jerinabr/XIAO-ESP32C6-Lighting-Control-Board/XIAO_ESP32C6_Control_Board.kicad_pcb

## KiCad design XIAO_ESP32C6_Control_Board.kicad_pcb (2026-08-29)

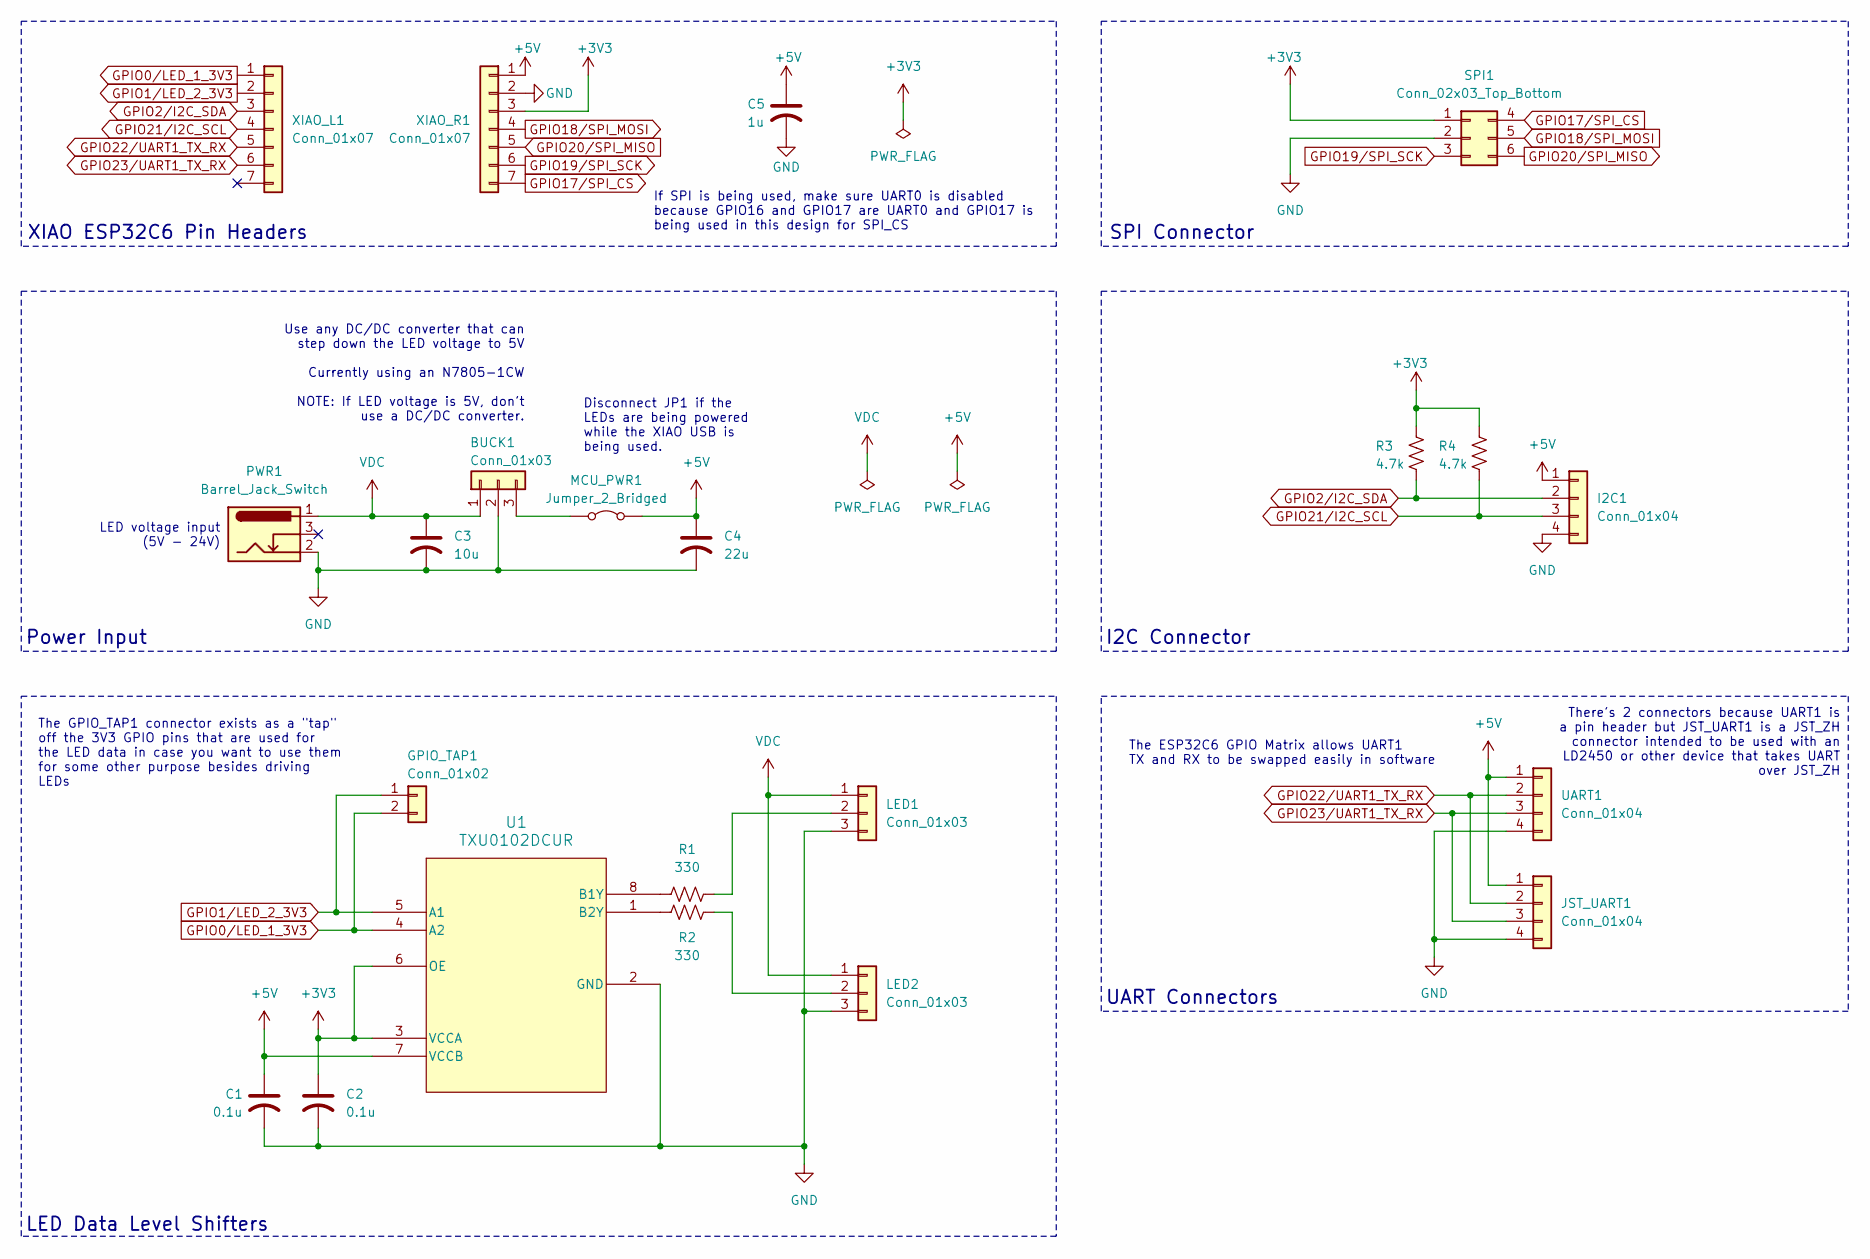
[picture p5: schematic XIAO_ESP32C6_Control_Board.kicad_sch]

Parts:
BUCK1: Conn_01x03; PinHeader_1x03_P2.54mm_Vertical
C1, C2: 0.1u; C_0603_1608Metric_Pad1.08x0.95mm_HandSolder
C3: 10u; C_1210_3225Metric_Pad1.33x2.70mm_HandSolder
C4: 22u; C_1210_3225Metric_Pad1.33x2.70mm_HandSolder
C5: 1u; C_0603_1608Metric_Pad1.08x0.95mm_HandSolder
GPIO_TAP1: Conn_01x02; PinHeader_1x02_P2.54mm_Vertical
I2C1: Conn_01x04; PinHeader_1x04_P2.54mm_Vertical
JST_UART1: Conn_01x04; JST_ZH_B4B-ZR_1x04_P1.50mm_Vertical
LED1, LED2: Conn_01x03; PinHeader_1x03_P2.54mm_Vertical
MCU_PWR1: Jumper_2_Bridged; PinHeader_1x02_P2.54mm_Vertical
PWR1: Barrel_Jack_Switch; CUI_PJ-002AH
R1, R2: 330; R_0603_1608Metric_Pad0.98x0.95mm_HandSolder
R3, R4: 4.7k; R_0603_1608Metric_Pad0.98x0.95mm_HandSolder
SPI1: Conn_02x03_Top_Bottom; PinHeader_2x03_P2.54mm_Vertical
U1: TXU0102DCUR; SOIC8_DCU_TEX
UART1: Conn_01x04; PinHeader_1x04_P2.54mm_Vertical
XIAO_L1: Conn_01x07; PinSocket_1x07_P2.54mm_Vertical; MPN SSK02-FPH-254-A7
XIAO_R1: Conn_01x07; PinSocket_1x07_P2.54mm_Vertical; MPN SSK02-FPH-254-A7

Connections:
+3V3: C2.1, R3.1, R4.1, SPI1.1, U1.3 (VCCA), U1.6 (OE), XIAO_R1.3
+5V: C1.1, C4.1, C5.1, I2C1.1, JST_UART1.1, MCU_PWR1.2 (B), U1.7 (VCCB), UART1.1, XIAO_R1.1
GND: BUCK1.2, C1.2, C2.2, C3.2, C4.2, C5.2, I2C1.4, JST_UART1.4, LED1.3, LED2.3, PWR1.2, SPI1.2, U1.2 (GND), UART1.4, XIAO_R1.2
GPIO0/LED_1_3V3: GPIO_TAP1.2, U1.4 (A2), XIAO_L1.1
GPIO1/LED_2_3V3: GPIO_TAP1.1, U1.5 (A1), XIAO_L1.2
GPIO2/I2C_SDA: I2C1.2, R3.2, XIAO_L1.3
GPIO17/SPI_CS: SPI1.4, XIAO_R1.7
GPIO18/SPI_MOSI: SPI1.5, XIAO_R1.4
GPIO19/SPI_SCK: SPI1.3, XIAO_R1.6
GPIO20/SPI_MISO: SPI1.6, XIAO_R1.5
GPIO21/I2C_SCL: I2C1.3, R4.2, XIAO_L1.4
GPIO22/UART1_TX_RX: JST_UART1.2, UART1.2, XIAO_L1.5
GPIO23/UART1_TX_RX: JST_UART1.3, UART1.3, XIAO_L1.6
unnamed: BUCK1.3, MCU_PWR1.1 (A)
unnamed: LED1.2, R1.2
unnamed: LED2.2, R2.1
unnamed: R1.1, U1.8 (B1Y)
unnamed: R2.2, U1.1 (B2Y)
VDC: BUCK1.1, C3.1, LED1.1, LED2.1, PWR1.1

Notes on the sheet:
There's 2 connectors because UART1 is a pin header but JST_UART1 is a JST_ZH connector intended to be used with an LD2450 or other device that takes UART over JST_ZH
LED voltage input (5V - 24V)
The GPIO_TAP1 connector exists as a "tap" off the 3V3 GPIO pins that are used for the LED data in case you want to use them for some other purpose besides driving LEDs
I2C Connector
Power Input
The ESP32C6 GPIO Matrix allows UART1 TX and RX to be swapped easily in software
SPI Connector
LED Data Level Shifters
UART Connectors
Disconnect JP1 if the LEDs are being powered while the XIAO USB is being used.
Use any DC/DC converter that can step down the LED voltage to 5V Currently using an N7805-1CW NOTE: If LED voltage is 5V, don't use a DC/DC converter.
XIAO ESP32C6 Pin Headers
If SPI is being used, make sure UART0 is disabled because GPIO16 and GPIO17 are UART0 and GPIO17 is being used in this design for SPI_CS

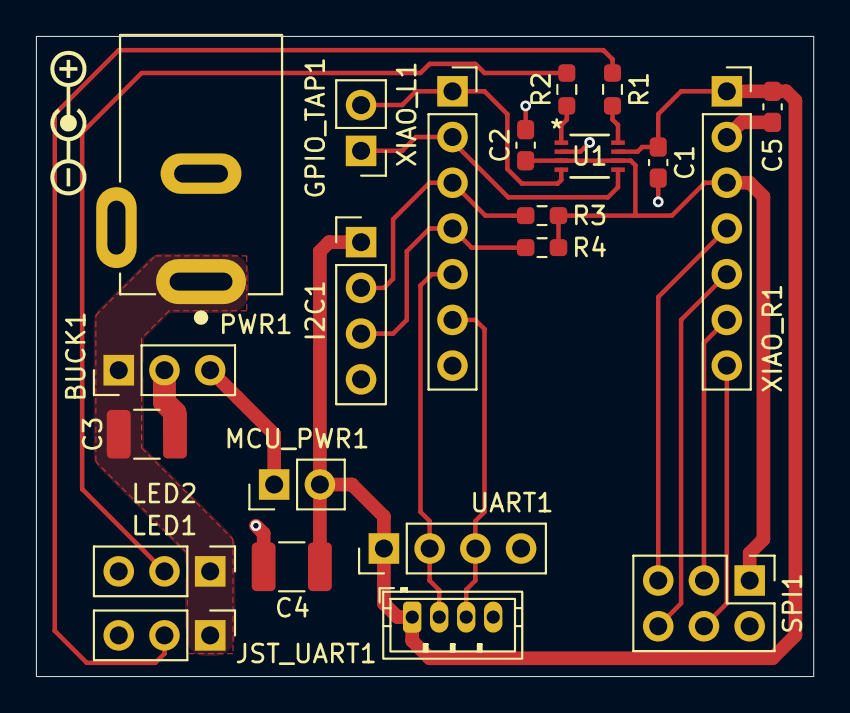
[picture p6: board XIAO_ESP32C6_Control_Board.kicad_pcb from above]

Board: 2 copper layers, 43.2 x 35.6 mm, 22 parts (0 on the bottom side), 19 nets.
