jerinabr/XIAO-ESP32C6-Lighting-Control-Board/(commit log)

2026-08-24 Create the schematic
    - Initial revision of the schematic
    - Also added gitignore to ignore the backups folder because we have
    version control now lol
    [XIAO_ESP32C6_Control_Board.kicad_pcb, XIAO_ESP32C6_Control_Board.kicad_sch]
2026-08-24 Added circuit protections
    - Added 330 ohm resistors to the level shifter outputs to make sure
    signal quality is good.
    - Probably not needed but doesn't hurt to have. I can always put a 0
    ohm resistor here instead
    - Added a polyfuse to the DC input
    - Again probably not needed but I'd rather not need it and have it
    than not have it and need it...
    [XIAO_ESP32C6_Control_Board.kicad_sch]
2026-08-28 Add footprints to schematic
    - Also removed the PTC fuse because the power supply has overcurrent
    protection
    [XIAO_ESP32C6_Control_Board.kicad_sch]
2026-08-28 Initial component layout
    [XIAO_ESP32C6_Control_Board.kicad_pcb, XIAO_ESP32C6_Control_Board.kicad_sch]
2026-08-28 Route board
    [XIAO_ESP32C6_Control_Board.kicad_pcb, XIAO_ESP32C6_Control_Board.kicad_sch]
2026-08-29 Add bottom silkscreen
    - Added silkscreen to help me figure out what pins go to what
    [XIAO_ESP32C6_Control_Board.kicad_pcb, XIAO_ESP32C6_Control_Board.kicad_sch]
2026-08-29 Add more silkscreen info
    - Added an input power polarity indicator silkscreen to make the
    center-positive input obvious
    - Added which GPIO each LED connector uses
    - Added which pins on the XIAO go to which peripheral pins
    [XIAO_ESP32C6_Control_Board.kicad_pcb]
2026-08-29 Move XIAO headers up
    - Moved the XIAO headers up to make the XIAO board edge flush with the
    carrier board edge
    - This way the USB-C connector sticks out slightly too which helps
    with mechanical strength in a 3D printed enclosure
    - This also moves the antenna further away from the other headers
    below it which should help RF performance a little bit probably
    - Also moved the level shifting circuitry up a bit too to make the trace
    routing a little shorter
    - Made the 3.3V trace to the SPI header thicker to match the other power
    trace thickness
    [XIAO_ESP32C6_Control_Board.kicad_pcb]
2026-08-29 Update XIAO decoupling cap value to 1uF
    - Mistakenly kept this at 0.1uF after copying it from the existing 0.1uF
    cap. This was meant to be 1uF
    - Luckily this doesn't affect the PCB itself since it's the same
    package
    - Moved the back silkscreen text up to match the position of the PCB
    - Unfortunately this was done AFTER I already sent the design to
    OSHPark...
    - Luckily it's not really important
    [XIAO_ESP32C6_Control_Board.kicad_pcb, XIAO_ESP32C6_Control_Board.kicad_sch]
2026-10-31 Add images and BOM
2026-10-31 Revise README for clarity and additional features
    Updated the README to clarify the board's purpose and features.
